Rat-Rig/V-Core-Pro-1.3/README.md

## Installation

[CAD(Fusion360)](https://a360.co/3uCLrpB)
<p>
Project Page

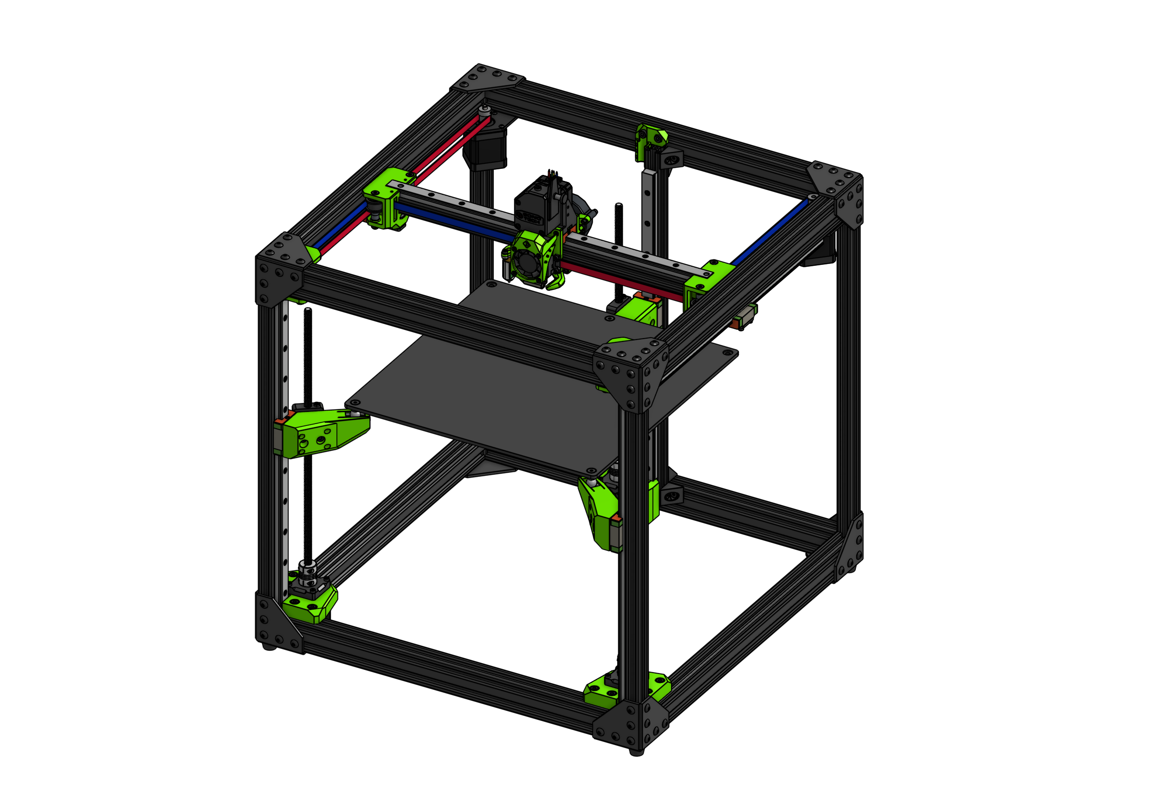
[picture p1: docs/assets/vcorepro.png]
