Rat-Rig/V-Core-Pro-1.3/docs/assets/360/main/V3_22.jpg

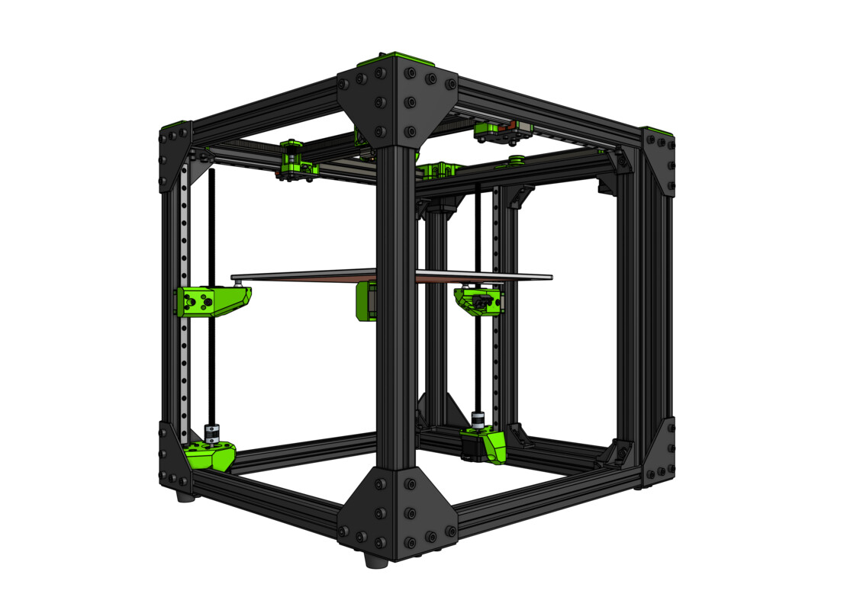
docs/assets/360/main/V3_22.jpg
