Rat-Rig/V-Core-Pro-1.3/docs/assets/eva/aero.png

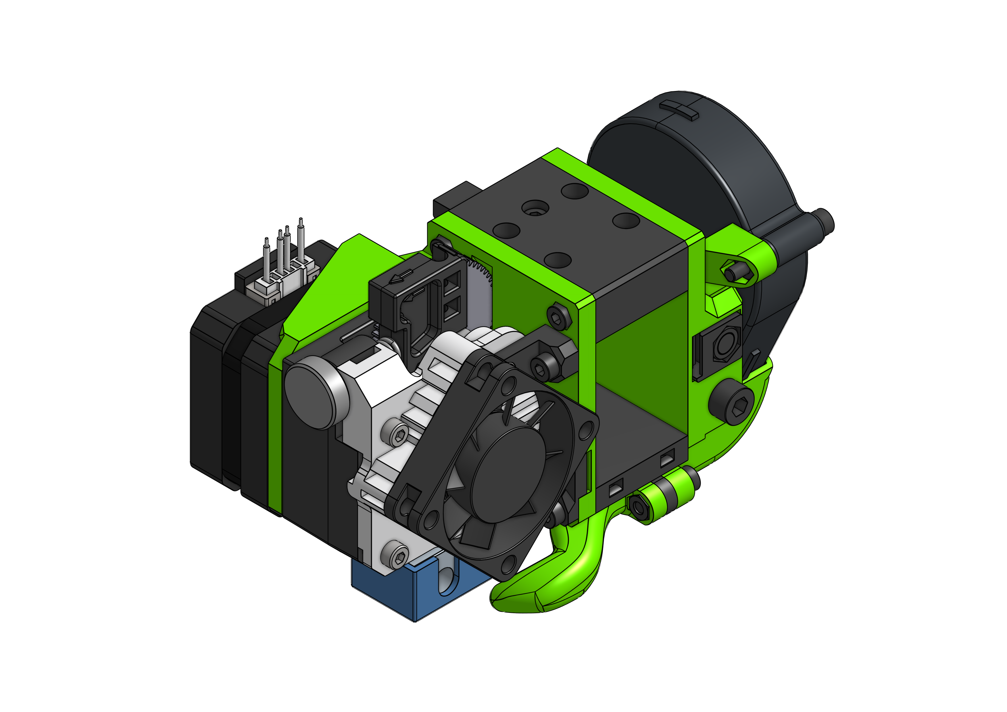
docs/assets/eva/aero.png
