Rat-Rig/V-Core-Pro-1.3/docs/assets/eva/bmg.png

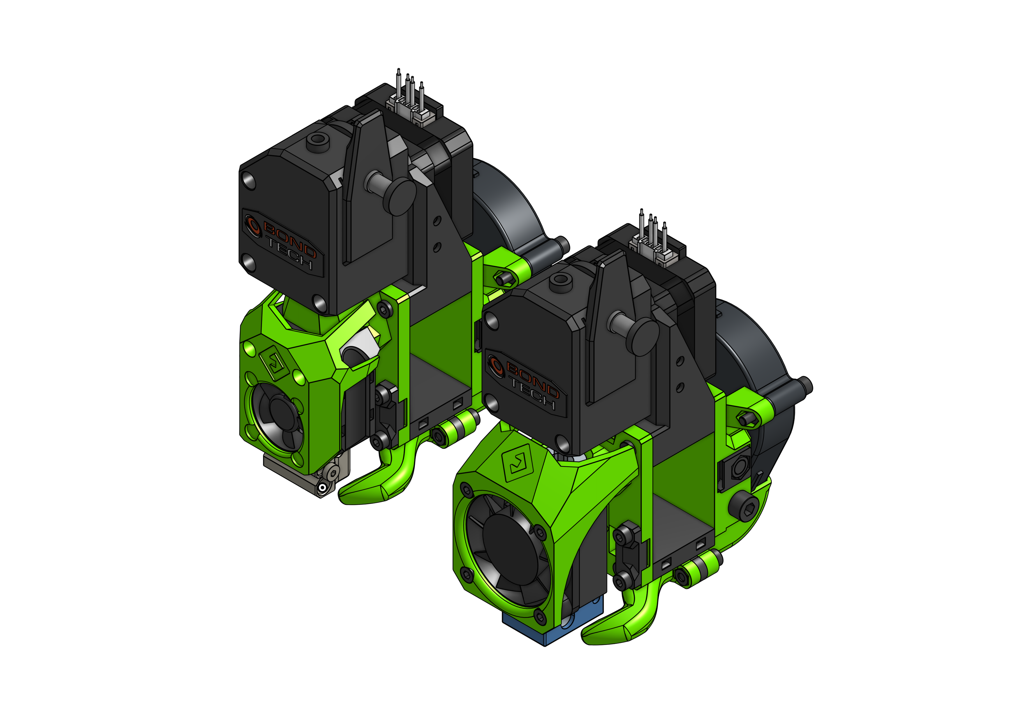
docs/assets/eva/bmg.png
