Rat-Rig/V-Core-Pro-1.3/docs/assets/eva/bowden.png

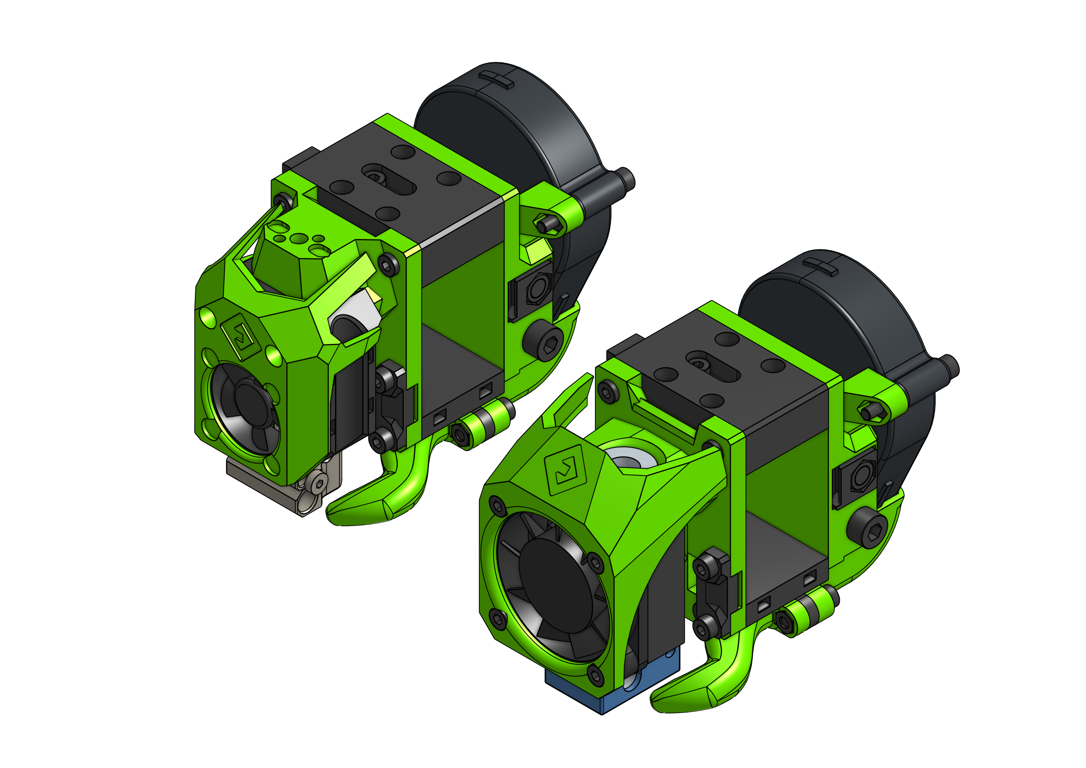
docs/assets/eva/bowden.png
