Rat-Rig/V-Core-Pro-1.3/docs/assets/eva/titan.png

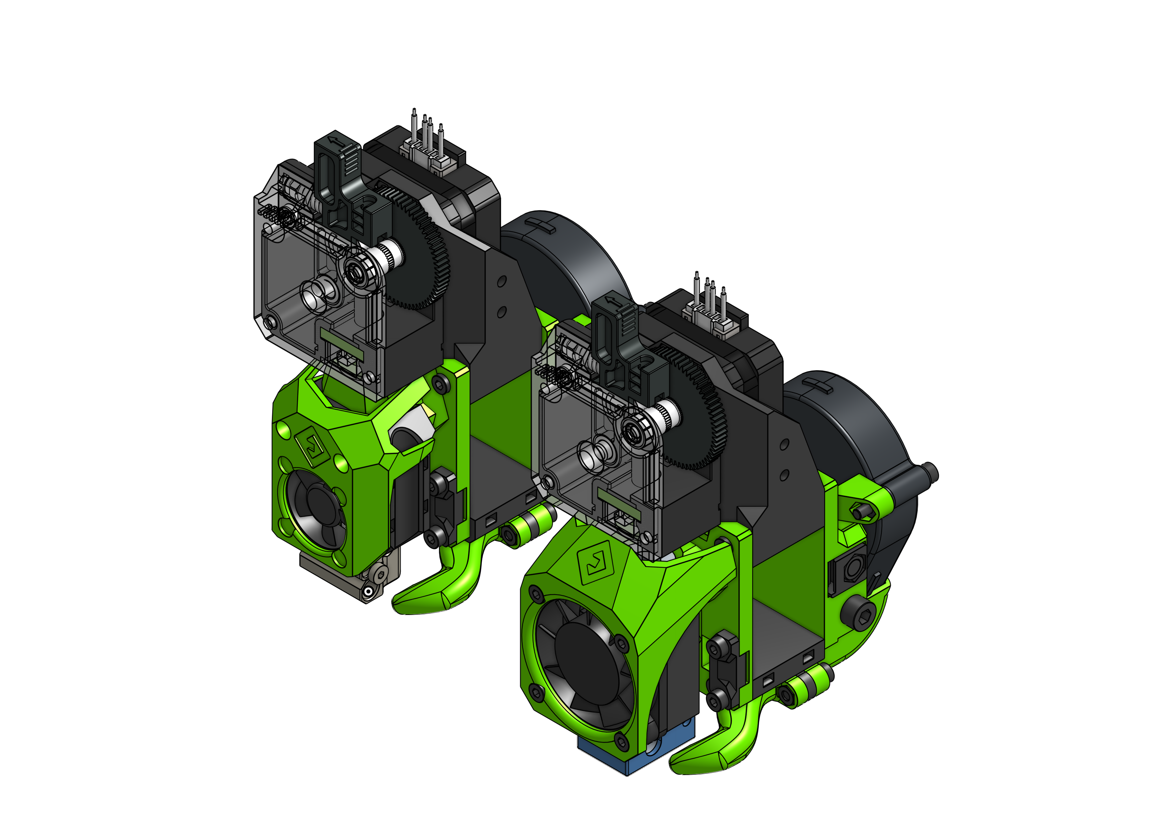
docs/assets/eva/titan.png
