Rat-Rig/V-Core-Pro-1.3/docs/assets/pad.png

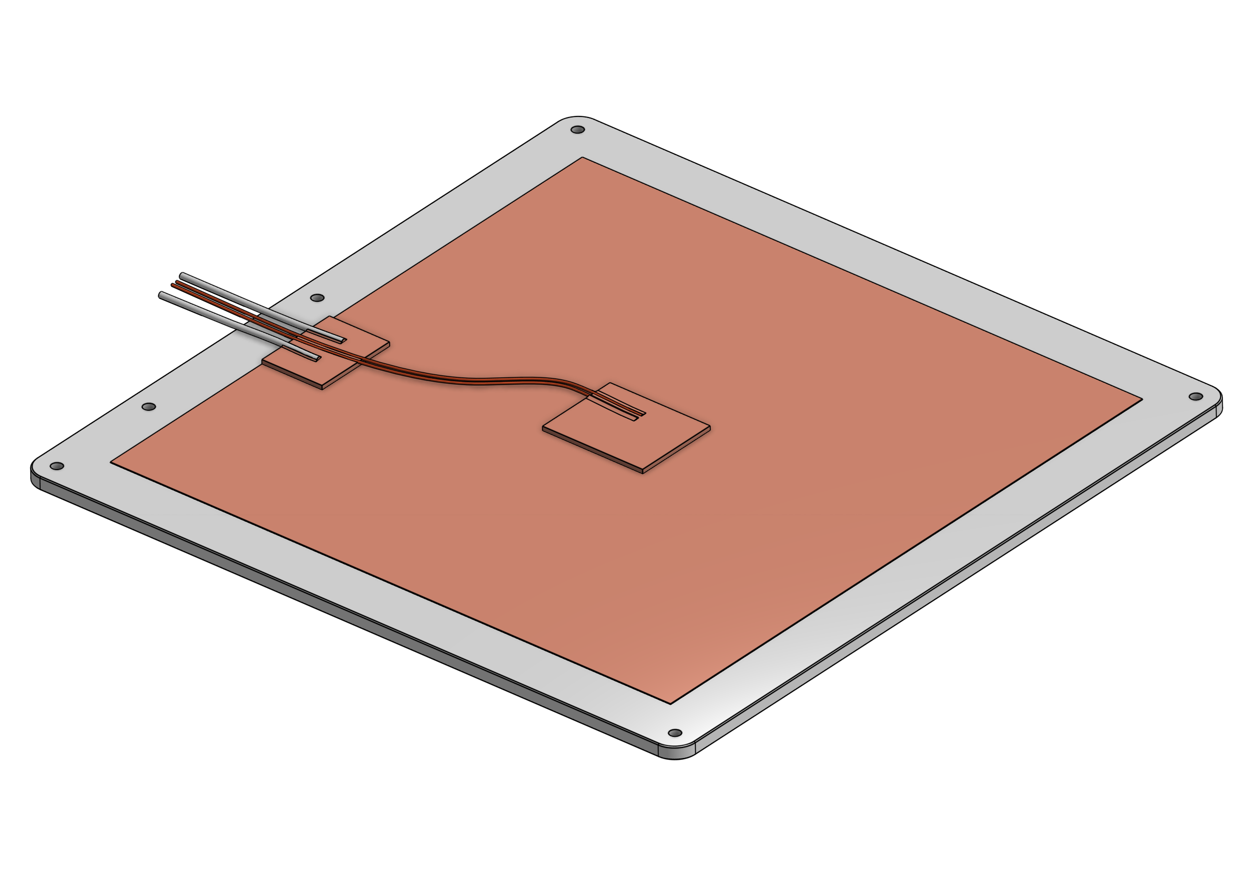
docs/assets/pad.png
