Rat-Rig/V-Core-Pro-1.3/docs/bom/Upgrade Kit from V-Core Pro 1.x to 1.3 - Base parts kit.csv

 | SKU |  |  | Product Name
 | HW2173MK |  |  | V-Core Pro 1.3 Upgrade: Base parts kit
 | B.O.M.
QTY | SKU | Length (mm) | Tap | Item name
3 | HW2128GC |  |  | Steel Ball - 12mm - Threaded M5
6 | HW2126GC |  |  | Dowel Pin - 3.0mm x 35.0mm
3 | HW2118WC |  |  | Thrust Bearing F8-16M
3 | HW1018NC |  |  | Aluminium Spacer - 6mm
3 | HW2349SC |  |  | Countersink Screw M5 (Single) (Length: 16mm)
8 | HW1153SC |  |  | Low Profile Screw - 8mm (Single)
3 | HW1155SC |  |  | Low Profile Screw - 15mm (Single)
23 | HW1504SC |  |  | Cap Head Screw M3 (Single) (Length: 20mm)
2 | HW1868SC |  |  | Cap Head Screw M3 (Single) (Length: 35mm)
2 | HW1210SC |  |  | Cap Head Screw M5 (Single) (Length: 8mm)
5 | HW1285SC |  |  | Cap Head Screw M5 (Single) (Length: 10mm)
12 | HW1287SC |  |  | Cap Head Screw M5 (Single) (Length: 16mm)
6 | HW1060SC |  |  | Cap Head Screw M5 (Single) (Length: 35mm)
16 | HW1505SC |  |  | Cap Head Screw M3 (Single) (Length: 10mm)
27 | HW1030NC |  |  | T-Nut - Drop In for 2020 - M5 (Single)
15 | HW1665NC |  |  | T-Nut - Drop In for 2020 - M3 (Single)
4 | HW1083BC |  |  | Corner Connector - 90 Degree Angle
6 | HW1126NC |  |  | Precision Shim - 10 x 5 x 1mm
3 | HW2127GC |  |  | Magnet - 20 x 10 x 5mm - Two hole (M3 Countersink screws)
6 | HW2137SC |  |  | Countersink Screw M3 (Single) (Length: 20mm)
8 | HW1251NC |  |  | Hex Locking Nut - M3
