Rat-Rig/V-Core-Pro-1.3/cad/01_essentials/XYaxis/STEP/Corner Right V1.0.step

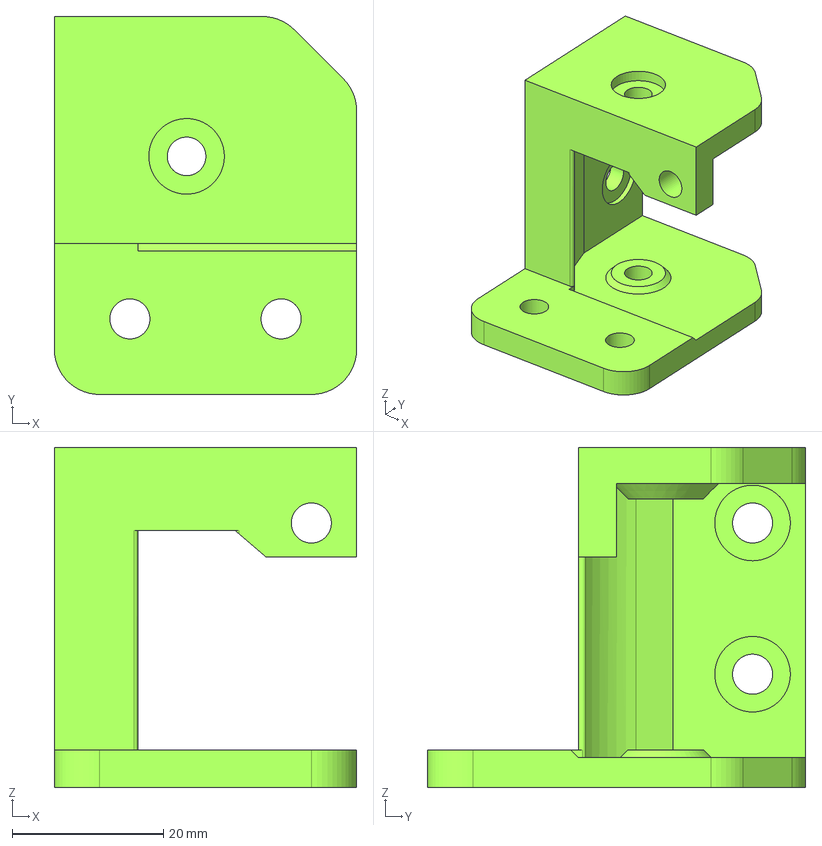
[picture p36: CAD file, 2021-03-04]
cad/01_essentials/XYaxis/STEP/Corner Right V1.0.step
40.0 x 50.0 x 45.0 mm
