Rat-Rig/V-Core-Pro-1.3/cad/01_essentials/Zaxis/STEP/Z Motor Back V1.0.step

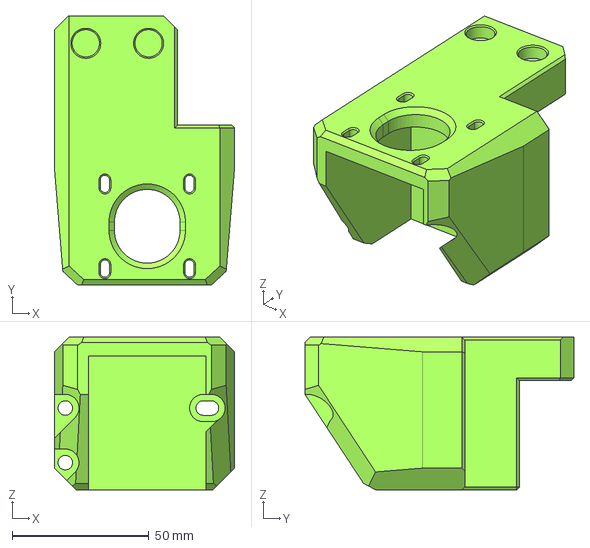
[picture p37: CAD file, 2021-03-10]
cad/01_essentials/Zaxis/STEP/Z Motor Back V1.0.step
66.0 x 98.5 x 56.0 mm
