Rat-Rig/V-Core-Pro-1.3/cad/01_essentials/Zaxis/STEP/MGN15 2020 Centering Tool V1.0.step

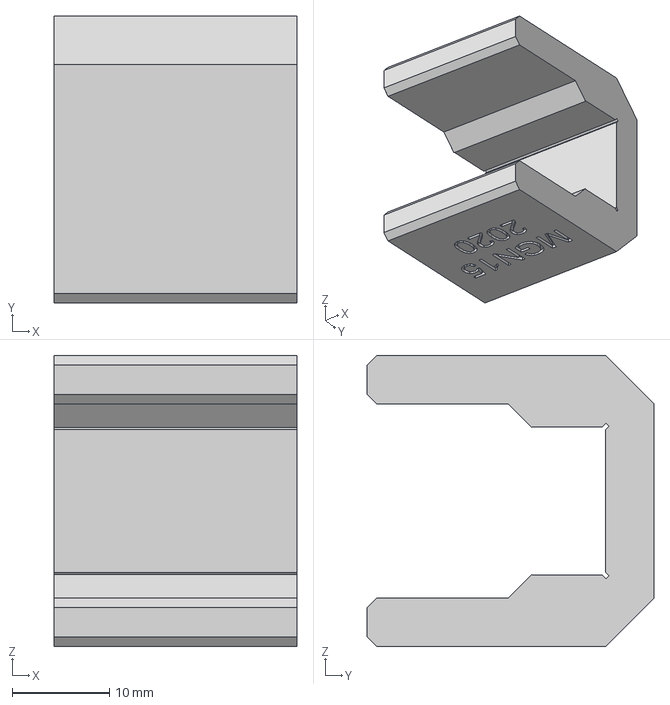
[picture p38: CAD file, 2021-03-04]
cad/01_essentials/Zaxis/STEP/MGN15 2020 Centering Tool V1.0.step
25.0 x 29.6 x 30.0 mm
