Rat-Rig/V-Core-Pro-1.3/cad/02_extras/STEP/spool_holder_guide.step

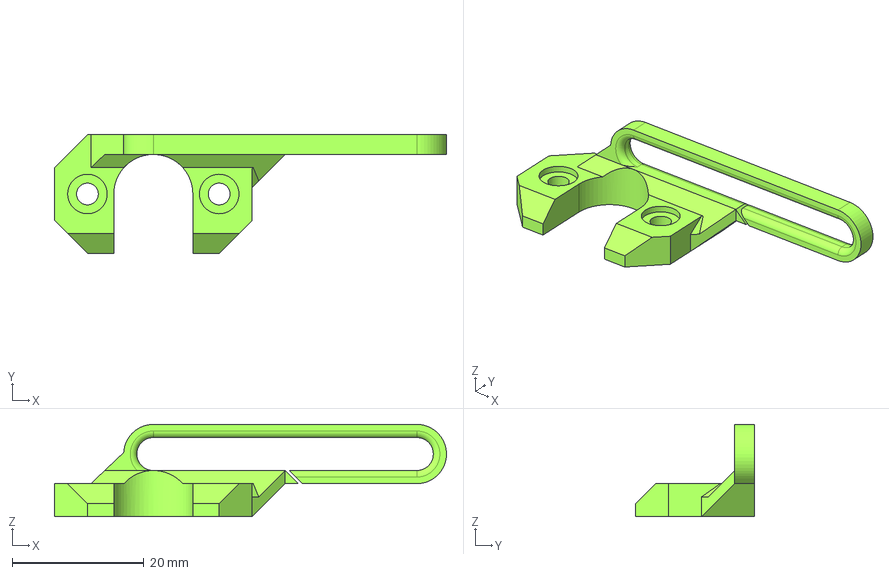
[picture p39: CAD file, 2021-03-18]
cad/02_extras/STEP/spool_holder_guide.step
59.5 x 18.0 x 14.0 mm
