Rat-Rig/V-Core-Pro-1.3/cad/01_essentials/XYaxis/STEP/XY Joiner Right V1.0.step

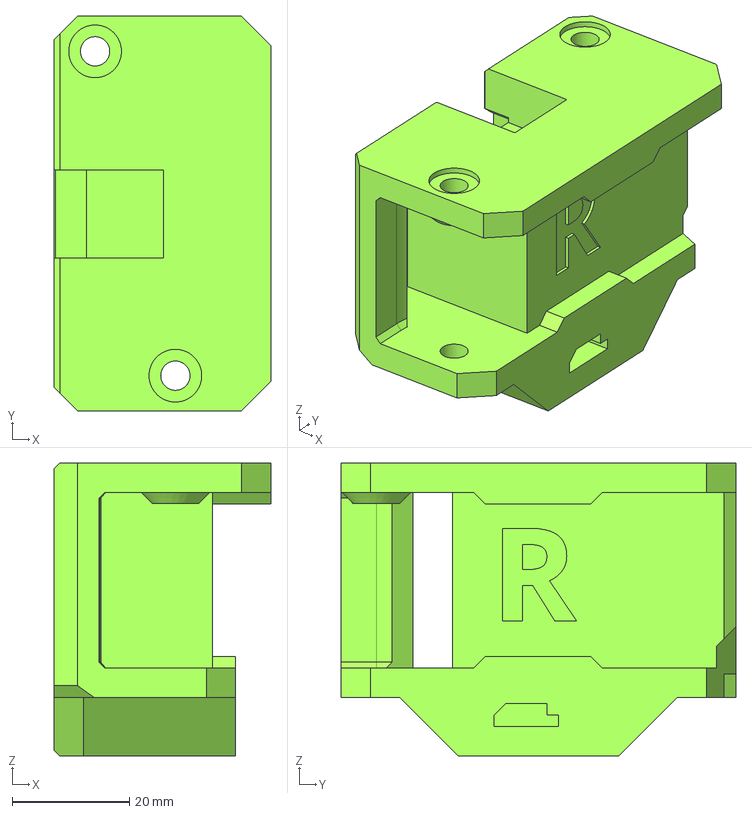
[picture p40: CAD file, 2021-03-04]
cad/01_essentials/XYaxis/STEP/XY Joiner Right V1.0.step
37.0 x 67.3 x 50.0 mm
