Rat-Rig/V-Core-Pro-1.3/cad/01_essentials/Zaxis/STEP/Left Arm V1.0.step

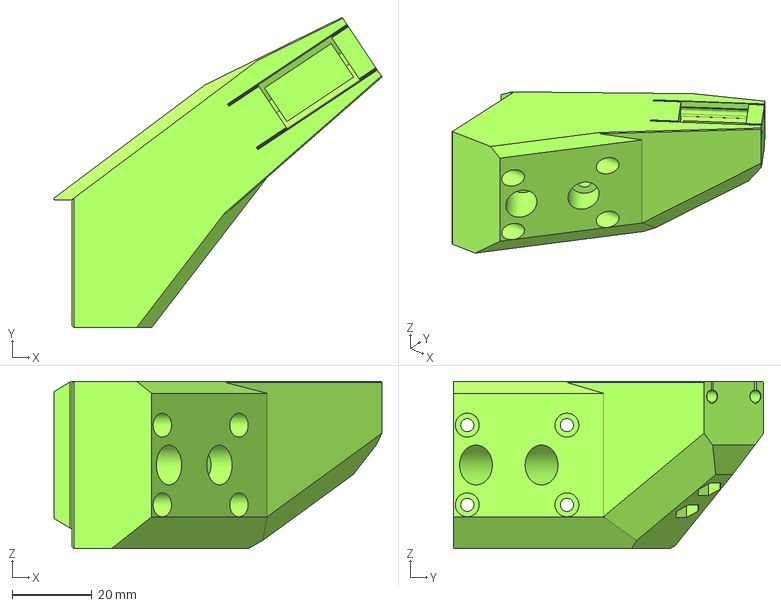
[picture p41: CAD file, 2021-03-04]
cad/01_essentials/Zaxis/STEP/Left Arm V1.0.step
82.3 x 77.9 x 42.0 mm
