Rat-Rig/V-Core-Pro-1.3/cad/02_extras/STEP/spool_holder_knob.step

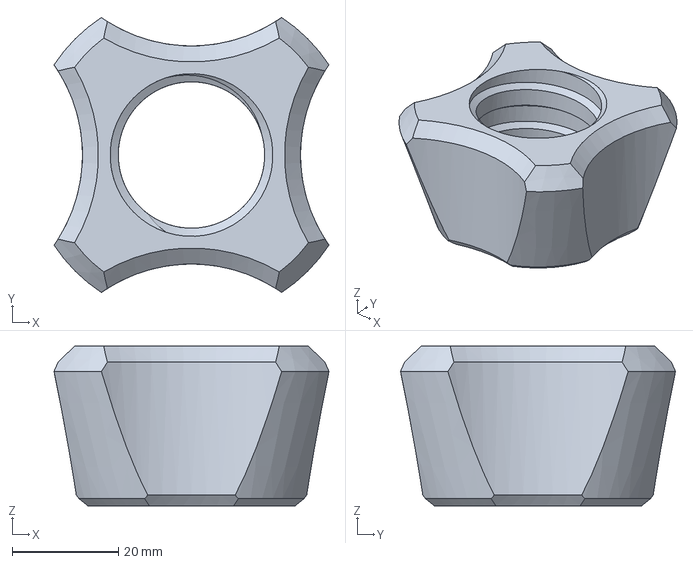
[picture p42: CAD file, 2021-03-18]
cad/02_extras/STEP/spool_holder_knob.step
51.7 x 51.7 x 30.0 mm
