Rat-Rig/V-Core-Pro-1.3/cad/01_essentials/Zaxis/STEP/Z Motor Front Left V1.0.step

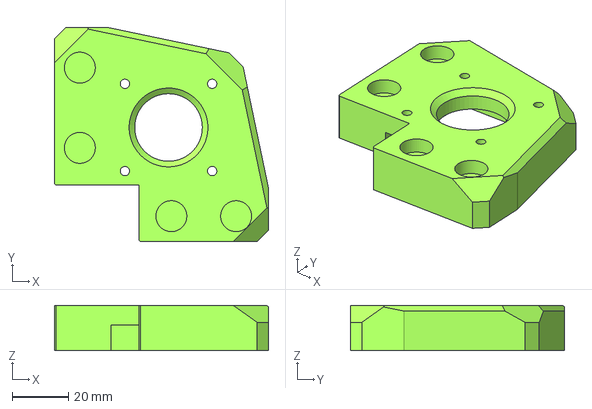
[picture p43: CAD file, 2021-03-04]
cad/01_essentials/Zaxis/STEP/Z Motor Front Left V1.0.step
76.0 x 76.0 x 16.0 mm
