Rat-Rig/V-Core-Pro-1.3/cad/02_extras/STEP/spool_holder_2020_arm_v2_rr.step

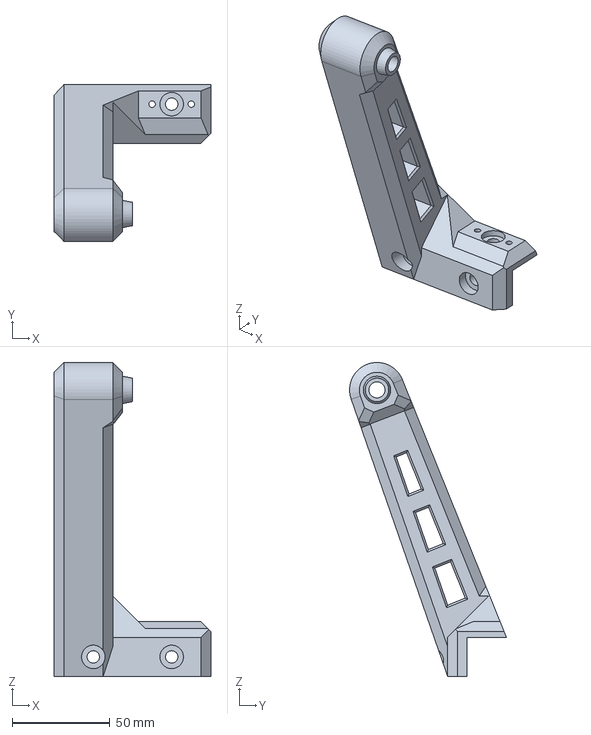
[picture p44: CAD file, 2021-03-18]
cad/02_extras/STEP/spool_holder_2020_arm_v2_rr.step
80.0 x 80.0 x 160.2 mm
