Rat-Rig/V-Core-Pro-1.3/cad/01_essentials/Zaxis/STEP/Z Coupler Support V1.0.step

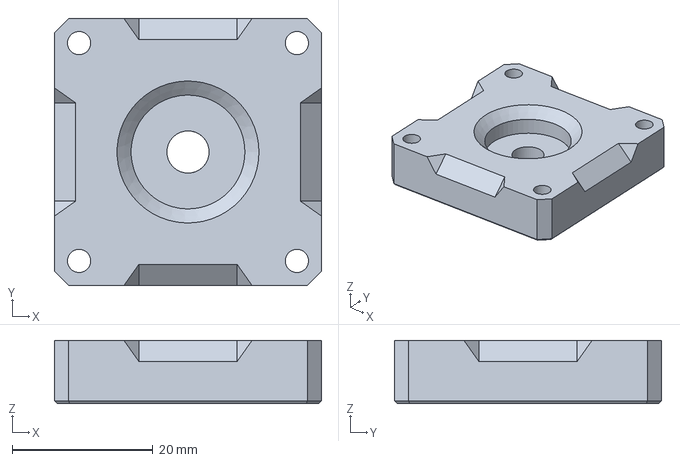
[picture p45: CAD file, 2021-03-04]
cad/01_essentials/Zaxis/STEP/Z Coupler Support V1.0.step
38.0 x 38.0 x 9.00 mm
