Rat-Rig/V-Core-Pro-1.3/cad/02_extras/STEP/Bed Cable Relief V1.0.step

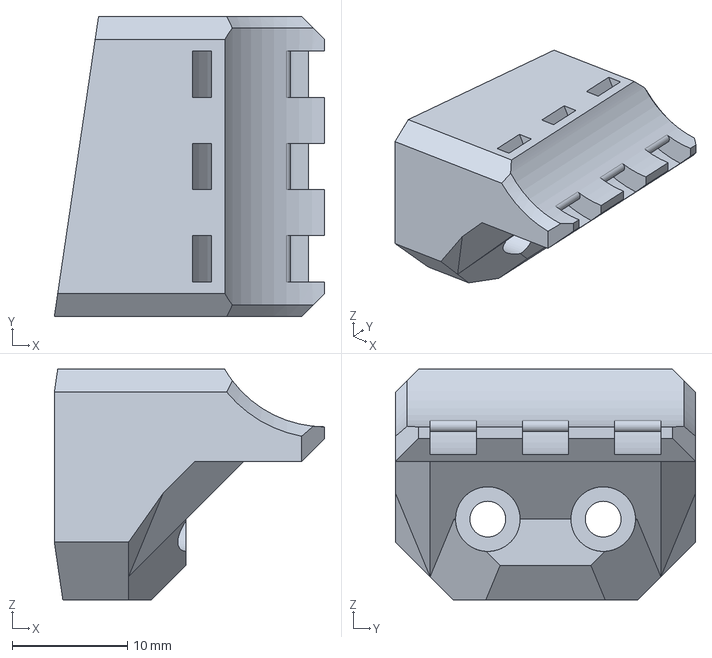
[picture p46: CAD file, 2021-03-04]
cad/02_extras/STEP/Bed Cable Relief V1.0.step
23.4 x 26.0 x 20.0 mm
