Rat-Rig/V-Core-Pro-1.3/cad/02_extras/STEP/Back Cable Relief V1.0.step

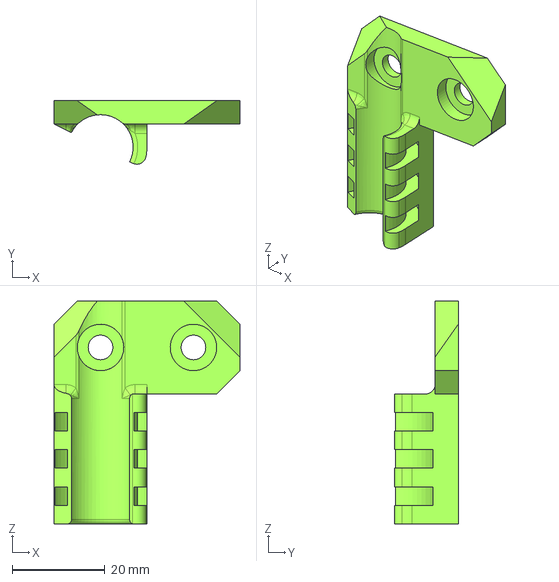
[picture p47: CAD file, 2021-03-04]
cad/02_extras/STEP/Back Cable Relief V1.0.step
40.0 x 13.7 x 48.0 mm
