Rat-Rig/V-Core-Pro-1.3/cad/01_essentials/Zaxis/STEP/Back Arm V1.0.step

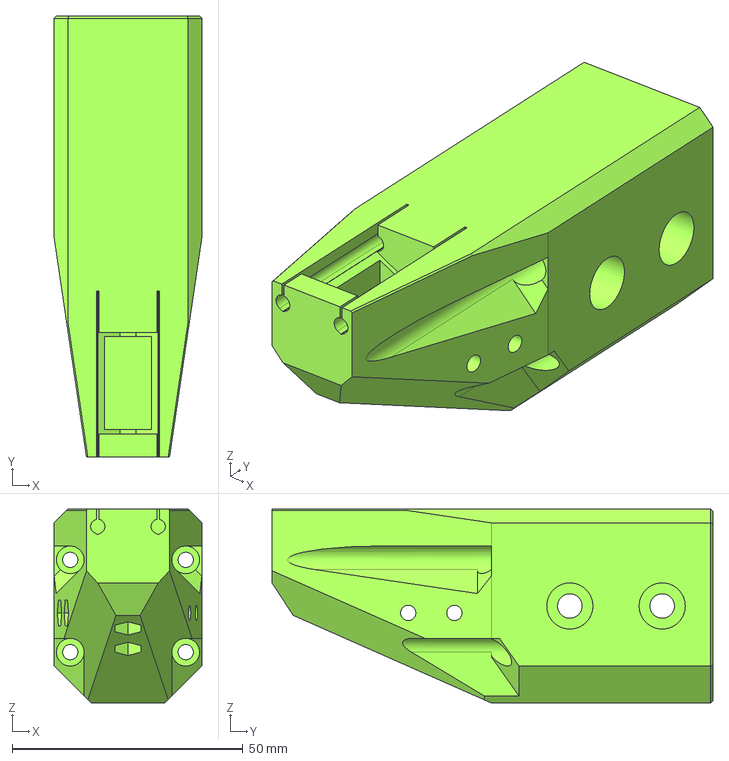
[picture p48: CAD file, 2021-03-04]
cad/01_essentials/Zaxis/STEP/Back Arm V1.0.step
32.0 x 95.5 x 42.0 mm
