Rat-Rig/V-Core-Pro-1.3/cad/02_extras/STEP/spool_holder_screw_80mm.step

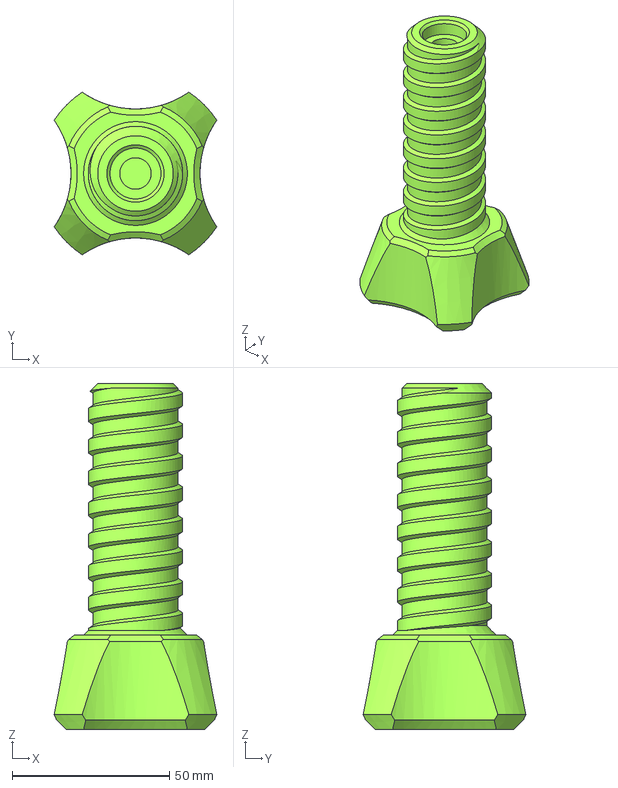
[picture p49: CAD file, 2021-03-18]
cad/02_extras/STEP/spool_holder_screw_80mm.step
51.7 x 51.7 x 110.0 mm
