Rat-Rig/V-Core-Pro-1.3/(list of files, cad)

Other CAD files:
cad/01_essentials/XYaxis/STEP/Corner Left V1.0.step
cad/01_essentials/XYaxis/STEP/XY Joiner Left V1.0.step
cad/01_essentials/Zaxis/STEP/Right Arm V1.0.step
cad/01_essentials/Zaxis/STEP/Z Motor Front Right V1.0.step
cad/01_essentials/XYaxis/STL/Corner Left V1.0.stl
cad/01_essentials/XYaxis/STL/Corner Right V1.0.stl
cad/01_essentials/XYaxis/STL/XY Joiner Left V1.0.stl
cad/01_essentials/XYaxis/STL/XY Joiner Right V1.0.stl
cad/01_essentials/Zaxis/STL/Back Arm V1.0.stl
cad/01_essentials/Zaxis/STL/Left Arm V1.0.stl
cad/01_essentials/Zaxis/STL/MGN15 2020 Centering Tool V1.0.stl
cad/01_essentials/Zaxis/STL/Right Arm V1.0.stl
cad/01_essentials/Zaxis/STL/Z Coupler Support V1.0.stl
cad/01_essentials/Zaxis/STL/Z Motor Back V1.0.stl
cad/01_essentials/Zaxis/STL/Z Motor Front Left V1.0.stl
cad/01_essentials/Zaxis/STL/Z Motor Front Right V1.0.stl
cad/02_extras/STL/Back Cable Relief V1.0.stl
cad/02_extras/STL/Bed Cable Relief V1.0.stl
cad/02_extras/STL/spool_holder_2020_arm_v2_rr.stl
cad/02_extras/STL/spool_holder_guide.stl
cad/02_extras/STL/spool_holder_knob.stl
cad/02_extras/STL/spool_holder_screw_80mm.stl
