Rat-Rig/V-Core-Pro-1.3/docs/assets/guide.png

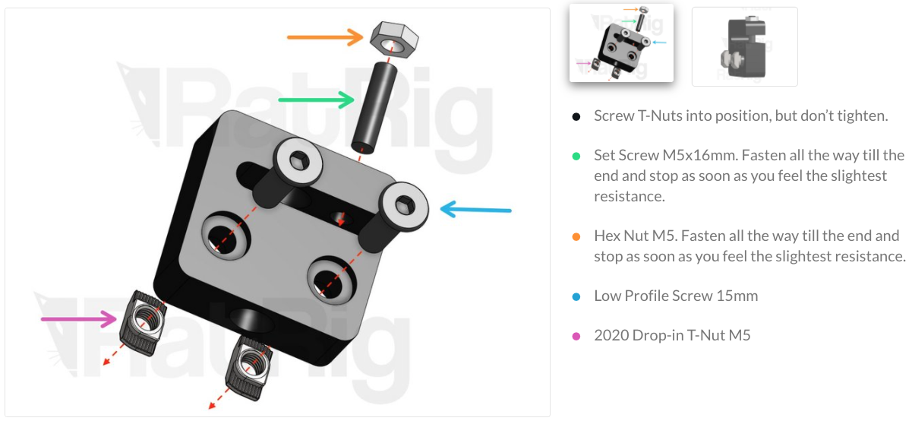
docs/assets/guide.png
