Rat-Rig/V-Core-Pro-1.3/(threads)

Thread 1 (2021-07-06):

[EP] Endstop block .step for remix/modification

shuffleznl, 2021-07-06:
Even though sensorless homing is probably way of the world, physical endstops often are a great safety feature.
Also not all pre-release steppers/boards (Recore :)) are sensorless capable (yet).

Kindly requesting release of .step of https://www.thingiverse.com/thing:4151822/files for earlier EVA/Easymod to remix.
Would like to mount the X-endstop on XY Joiner (rather than on carriage as with EVA2.x).

Also looking into remixing into 'flags' for optical endstops.

Cheers!

_Edit: if this belongs on Easy-mod git, please close this issue and I'll post there._

pkucmus, 2021-07-07:
Hello, It does belong in Easy-Mod but since EM is swallowed by V-Core Pro I think both are fine :)

Please see: https://github.com/EVA-3D/easy-mod#source, maybe EM's page will provide additional context: https://easy-mod.eva-3d.page/

From the source document (Onshape) you will be able to export the files in many formats, STEP is one of them.

Closed 2021-07-10.

Thread 2 (2022-01-28):

help with v-core 1.3 parts

midicdj1000, 2022-01-28:
HI, I am looking to make my own core xy printer from many parts I have on hand and I was looking to use the gantry parts you have shared. XY Joiner Right V1.0 and left. It has a fitting to secure this part to the bearing rails and you are using a captive nut of some type, but I am not able to find what type you have used. So far I have not had any luck with m5 bolt or m5 t slot nuts.

I hope you can help or provide with the older v-core assembly ? I can only find upgrade guides.
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
