Rat-Rig/V-Core-Pro-1.3/(commit log)

2021-03-04 Add test stl
    [iec_socket_adapter.stl]
2021-03-04 stls and steps
    [Back Arm V1.0.step, Back Arm V1.0.stl, Back Cable Relief V1.0.step, Back Cable Relief V1.0.stl, Bed Cable Relief V1.0.stl, Corner Left V1.0.step, Corner Left V1.0.stl, Corner Right V1.0.step]
2021-03-04 step file
    [Bed Cable Relief V1.0.step]
2021-03-04 naming folders
    [Back Arm V1.0.step, Back Arm V1.0.stl, Back Cable Relief V1.0.step, Back Cable Relief V1.0.stl, Bed Cable Relief V1.0.step, Bed Cable Relief V1.0.stl, Corner Left V1.0.step, Corner Left V1.0.stl]
2021-03-10 Add 1.3 docs page, add BOMs
    [Corner Left V1.0.step, Corner Left V1.0.stl, Corner Right V1.0.step, Corner Right V1.0.stl, V-Core Pro 1.3 BOM - Base.csv, V-Core Pro 1.3 BOM - FROM 1.1.csv, V-Core Pro 1.3 BOM - FROM 1.2.csv, V-Core Pro 1.3 BOM - Hardware.csv]
2021-03-11 Fix extras urls
    [printed_parts.csv]
2021-03-11 Fix verbiage, reorganize BOM
    [V-Core Pro 1.3 BOM - Base.csv, V-Core Pro 1.3 BOM - FROM 1.1.csv, V-Core Pro 1.3 BOM - FROM 1.2.csv, V-Core Pro 1.3 BOM - Hardware.csv, printed_parts.csv]
2021-03-11 add csv download buttons
2021-03-12 Upgrade BOM
    [V-Core Pro 1.3 BOM - FROM 1.1.csv, V-Core Pro 1.3 BOM - FROM 1.2.csv]
2021-03-18 Add spool holder, move MGN allingment tool to Zaxis
    [MGN15 2020 Centering Tool V1.0.step, MGN15 2020 Centering Tool V1.0.stl, printed_parts.csv, spool_holder_2020_arm_v2_rr.step, spool_holder_2020_arm_v2_rr.stl, spool_holder_guide.step, spool_holder_guide.stl, spool_holder_knob.step]
2021-03-31 update teh BOM
    [Upgrade Kit from V-Core Pro 1.x to 1.3 - Base parts kit.csv, Upgrade Kit from V-Core Pro 1.x to 1.3 - FROM v1.1.csv, Upgrade Kit from V-Core Pro 1.x to 1.3 - FROM v1.2.csv, Upgrade Kit from V-Core Pro 1.x to 1.3 - full.csv, V-Core Pro 1.3 BOM - FROM 1.1.csv, V-Core Pro 1.3 BOM - FROM 1.2.csv]
2021-03-31 Collapse CSV boms link to one button
